dren-dk/HAL900/README

This project has been moved to gitlab: 
https://gitlab.com/dren.dk/HAL900
