dren-dk/HAL900/door-ctrl/firmware/em4100_protocol_files/psk_encoding.jpg

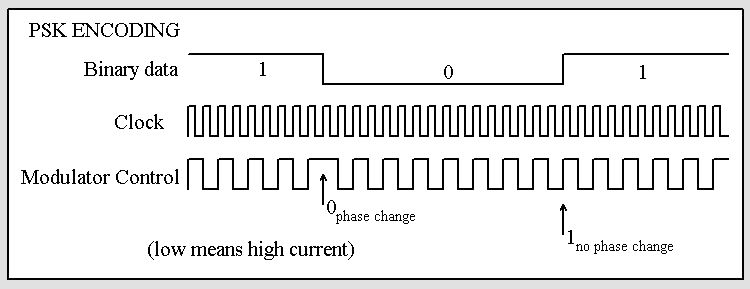
door-ctrl/firmware/em4100_protocol_files/psk_encoding.jpg
