dren-dk/HAL900/door-ctrl/historic/hardware-2.0/cerberus-h2.ods

Value | Component names | ELFA | Count | Price 1 | OSAA | URL | Normal total | OSAA total | ELFA | Count | Actual price
100nF 0805 | C1 C2 C6 C7 C8 C9 C10 C11 C12 C13 C14 C19 C23 C26 C28 C29 C31 | 65-724-19 | 17 | 0.37 | 0.08 | https://www.elfa.se/elfa3~dk_en/elfa/init.do?item=65-724-19 | 6.29 | 1.36 | 65-724-19 | 200 | 16
10uF 0805 | C15 C16 | 65-721-11 | 2 | 0.96 | 0.52 | https://www.elfa.se/elfa3~dk_en/elfa/init.do?item=65-721-11 | 1.92 | 1.04 | 65-721-11 | 20 | 10.4
2.2 uF C1206 | C20 | 65-834-54 | 1 | 1.09 | 0.258 | https://www.elfa.se/elfa3~dk_en/elfa/init.do?item=65-834-54 | 1.09 | 0.26 | 65-834-54 | 10 | 2.58
2.2 nF 0805 | C21 | 65-724-09 | 1 | 0.37 | 0.08 | https://www.elfa.se/elfa3~dk_en/elfa/init.do?item=65-724-09 | 0.37 | 0.08 | 65-724-09 | 10 | 0.8
33nF 0805 | C22 | 65-766-72 | 1 | 0.08 | 0.08 | https://www.elfa.se/elfa3~dk_en/elfa/init.do?item=65-766-72 | 0.08 | 0.08 | 65-766-72 | 10 | 0.8
3n3 0805 | C24 | 65-724-10 | 1 | 0.37 | 0.08 | https://www.elfa.se/elfa3~dk_en/elfa/init.do?item=65-724-10 | 0.37 | 0.08 | 65-724-10 | 10 | 0.8
1nF 0805 | C25 C27 C30 | 65-724-07 | 3 | 0.37 | 0.08 | https://www.elfa.se/elfa3~dk_en/elfa/init.do?item=65-724-07 | 1.11 | 0.24 | 65-724-07 | 30 | 2.4
10uF 1210 | C3 | 65-721-16 | 1 | 3.01 | 1.84 | https://www.elfa.se/elfa3~dk_en/elfa/init.do?item=65-721-16 | 3.01 | 1.84 | 65-721-16 | 5 | 9.2
16p 0805 | C4 C5 | 65-723-94 | 2 | 0.37 | 0.08 | https://www.elfa.se/elfa3~dk_en/elfa/init.do?item=65-723-94 | 0.74 | 0.16 | 65-723-94 | 20 | 1.6
 |  |  |  |  |  |  |  |  |  |  | 0
MINIMELF | D1 D2 D16 | 70-186-09 | 3 | 0.42 | 0.21 | https://www.elfa.se/elfa3~dk_en/elfa/init.do?item=70-186-09 | 1.26 | 0.63 | 70-186-09 | 30 | 6.3
3v6 SOD80C | D14 | 70-090-67 | 1 | 0.431 | 0.242 | https://www.elfa.se/elfa3~dk_en/elfa/init.do?item=70-090-67 | 0.43 | 0.24 | 70-090-67 | 10 | 2.42
TO220ACS | D15 | 70-140-30 | 1 | 4.33 | 2.57 | https://www.elfa.se/elfa3~dk_en/elfa/init.do?item=70-140-30 | 4.33 | 2.57 | 70-140-30 | 6 | 15.42
BAV70 SOT23 | D3 D4 D5 D6 D7 D8 D9 D10 D11 D12 D13 | 70-306-87 | 11 | 1.07 | 0.321 | https://www.elfa.se/elfa3~dk_en/elfa/init.do?item=70-306-87 | 11.77 | 3.53 | 70-306-87 | 50 | 16.05
 |  |  |  |  |  |  |  |  | 0 |  | 0
ENC28J60SS SSOP28 | IC1 | 73-867-45 | 1 | 19.8 | 15.3 | https://www.elfa.se/elfa3~dk_en/elfa/init.do?item=73-867-45 | 19.80 | 15.30 | 73-867-45 | 5 | 76.5
ATmega168 TQFP32-08 | IC2 | 73-647-08 | 1 | 39.2 | 19 | https://www.elfa.se/elfa3~dk_en/elfa/init.do?item=73-647-08 | 39.20 | 19.00 | 73-647-08 | 5 | 95
24LC64SN SO-08 | IC3 | 73-786-19 | 1 | 6.67 | 3.16 | https://www.elfa.se/elfa3~dk_en/elfa/init.do?item=73-786-19 | 6.67 | 3.16 | 73-786-19 | 5 | 15.8
LD117AS33TR SOT223 | IC4 | 73-067-85 | 1 | 6.67 | 4.03 | https://www.elfa.se/elfa3~dk_en/elfa/init.do?item=73-067-85 | 6.67 | 4.03 | 73-067-85 | 5 | 20.15
LM358 SO08 | IC6 | 73-301-29 | 1 | 3.59 | 1.76 | https://www.elfa.se/elfa3~dk_en/elfa/init.do?item=73-301-29 | 3.59 | 1.76 | 73-301-29 | 5 | 8.8
MC78M05CDTG DPACK | IC7 | 73-286-76 | 1 | 2.64 | 1.84 | https://www.elfa.se/elfa3~dk_en/elfa/init.do?item=73-286-76 | 2.64 | 1.84 | 73-286-76 | 5 | 9.2
 |  |  |  |  |  |  |  |  | 0 |  | 0
HF33F/012-ZS3 047 G5SB | K1 K2 | 37-157-45 | 2 | 15 | 10.7 | https://www.elfa.se/elfa3~dk_en/elfa/init.do?item=37-157-45 | 30.00 | 21.40 | 37-157-45 | 4 | 42.8
 |  |  |  |  |  |  |  |  | 0 |  | 0
ferrite bead 0204V@1 | L1, L4 | 58-727-00 | 2 | 1.25 | 0.81 | https://www.elfa.se/elfa3~dk_en/elfa/init.do?item=58-727-00 | 2.50 | 1.62 | 58-727-00 | 10 | 8.1
220uH A26GFC | L3 | 58-113-71 | 1 | 14.6 | 9.09 | https://www.elfa.se/elfa3~dk_en/elfa/init.do?item=58-113-71 | 14.60 | 9.09 | 58-113-71 | 5 | 45.45
 |  |  |  |  |  |  |  |  | 0 |  | 0
CHIP-LED0805 | LED1 LED2 | 75-102-55 | 2 | 0.88 | 0.52 | https://www.elfa.se/elfa3~dk_en/elfa/init.do?item=75-102-55 | 1.76 | 1.04 | 75-102-55 | 20 | 10.4
25MHz HC49UP | Q1 | 74-521-96 | 1 | 4.77 | 2.79 | https://www.elfa.se/elfa3~dk_en/elfa/init.do?item=74-521-96 | 4.77 | 2.79 | 74-521-96 | 5 | 13.95
 |  |  |  |  |  |  |  |  | 0 |  | 0
470 0805 | R1 R2 R13 R15 | 60-174-12 | 4 | 0.712 | 0.228 | https://www.elfa.se/elfa3~dk_en/elfa/init.do?item=60-174-12 | 2.85 | 0.91 | 60-174-12 | 40 | 9.12
2k7 0805 | R10 | 60-175-94 | 1 | 0.712 | 0.228 | https://www.elfa.se/elfa3~dk_en/elfa/init.do?item=60-175-94 | 0.71 | 0.23 | 60-175-94 | 10 | 2.28
18k 0805 | R11 | 60-177-92 | 1 | 0.712 | 0.228 | https://www.elfa.se/elfa3~dk_en/elfa/init.do?item=60-177-92 | 0.71 | 0.23 | 60-177-92 | 10 | 2.28
4k7 0805 | R12 R14 R33 R35 R37 R51 R52 | 60-176-51 | 7 | 0.712 | 0.228 | https://www.elfa.se/elfa3~dk_en/elfa/init.do?item=60-176-51 | 4.98 | 1.60 | 60-176-51 | 50 | 11.4
1k 0805 | R16 R17 R18 R19 R20 R21 R22 R23 R24 R25 R26 R27 R28 R29 R30 R31 R32 R38 R39 R40 R48 | 60-174-95 | 21 | 0.712 | 0.228 | https://www.elfa.se/elfa3~dk_en/elfa/init.do?item=60-174-95 | 14.95 | 4.79 | 60-174-95 | 100 | 22.8
50 0805 | R3 R4 R5 R6 | 60-171-80 | 4 | 0.712 | 0.228 | https://www.elfa.se/elfa3~dk_en/elfa/init.do?item=60-171-80 | 2.85 | 0.91 | 60-171-80 | 40 | 9.12
6k2 0805 | R34 | 60-176-85 | 1 | 0.712 | 0.228 | https://www.elfa.se/elfa3~dk_en/elfa/init.do?item=60-176-85 | 0.71 | 0.23 | 60-176-85 | 10 | 2.28
15k 0805 | R36 | 60-177-76 | 1 | 0.712 | 0.228 | https://www.elfa.se/elfa3~dk_en/elfa/init.do?item=60-177-76 | 0.71 | 0.23 | 60-177-76 | 10 | 2.28
10R 0805 | R41 | 60-170-16 | 1 | 0.712 | 0.228 | https://www.elfa.se/elfa3~dk_en/elfa/init.do?item=60-170-16 | 0.71 | 0.23 | 60-170-16 | 10 | 2.28
100k 0805 | R43 R46 R50 | 60-179-74 | 3 | 0.712 | 0.228 | https://www.elfa.se/elfa3~dk_en/elfa/init.do?item=60-179-74 | 2.14 | 0.68 | 60-179-74 | 30 | 6.84
22k 0805 | R45 | 60-178-18 | 1 | 0.712 | 0.228 | https://www.elfa.se/elfa3~dk_en/elfa/init.do?item=60-178-18 | 0.71 | 0.23 | 60-178-18 | 10 | 2.28
330R 0805 | R7 R44 | 60-173-70 | 2 | 0.712 | 0.228 | https://www.elfa.se/elfa3~dk_en/elfa/init.do?item=60-173-70 | 1.42 | 0.46 | 60-173-70 | 20 | 4.56
10k 0805 | R8 R9 R42 R49 R53 | 60-177-35 | 5 | 0.712 | 0.228 | https://www.elfa.se/elfa3~dk_en/elfa/init.do?item=60-177-35 | 3.56 | 1.14 | 60-177-35 | 50 | 11.4
 |  |  |  |  |  |  |  |  | 0 |  | 0
ICSP MA03-2 | SV1 | 43-839-24 | 0.166666666666667 | 20.7 | 17 | https://www.elfa.se/elfa3~dk_en/elfa/init.do?item=43-839-24 | 3.45 | 2.83 | 43-839-24 | 1 | 17
serial MA06-2 | SV2 | 43-839-24 | 0.166666666666667 | 20.7 | 17 | https://www.elfa.se/elfa3~dk_en/elfa/init.do?item=43-839-24 | 3.45 | 2.83 | 43-839-24 | 1 | 17
GPIO MA06-2 | SV3 | 43-839-24 | 0.0833333333333333 | 20.7 | 17 | https://www.elfa.se/elfa3~dk_en/elfa/init.do?item=43-839-24 | 1.73 | 1.42 | 43-839-24 | 1 | 17
 |  |  |  |  |  |  |  |  | 0 |  | 0
BC817 SOT-23 | T1 T2 T4 T5 | 71-311-95 | 4 | 0.338 | 0.233 | https://www.elfa.se/elfa3~dk_en/elfa/init.do?item=71-311-95 | 1.35 | 0.93 | 71-311-95 | 40 | 9.32
BC807 SOT-23 | T3 | 71-311-98 | 1 | 0.409 | 0.281 | https://www.elfa.se/elfa3~dk_en/elfa/init.do?item=71-311-98 | 0.41 | 0.28 | 71-311-98 | 10 | 2.81
 |  |  |  |  |  |  |  |  | 0 |  | 0
W237-103 | X1 X2 | 48-375-14 | 2 | 3.67 | 1.62 | https://www.elfa.se/elfa3~dk_en/elfa/init.do?item=48-375-14 | 7.34 | 3.24 | 48-375-14 | 20 | 32.4
W237-102 | X3 | 48-375-06 | 1 | 2.5 | 1.1 | https://www.elfa.se/elfa3~dk_en/elfa/init.do?item=48-375-06 | 2.50 | 1.10 | 48-375-06 | 10 | 11
 |  |  |  |  |  | total pris for komponenter, normal og OSAA | 222.22 | 117.63 |  |  | 626.37
 |  |  |  |  |  | Incl. Moms | 277.78 | 147.04 |  |  | 782.9625
