dren-dk/HAL900/door-ctrl/historic/hardware-2.0/cerberus-h2-rfid.pdf

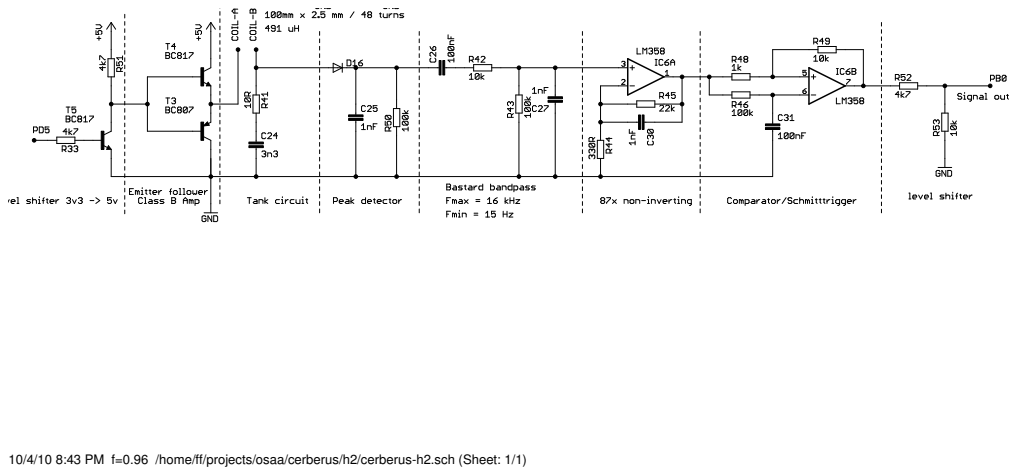
[picture p10: page 1]

10/4/10 8:43 PM f=0.96 /home/ff/projects/osaa/cerberus/h2/cerberus-h2.sch (Sheet: 1/1)
