dren-dk/HAL900/door-ctrl/historic/hardware-2.0/cerberus-h2.pdf

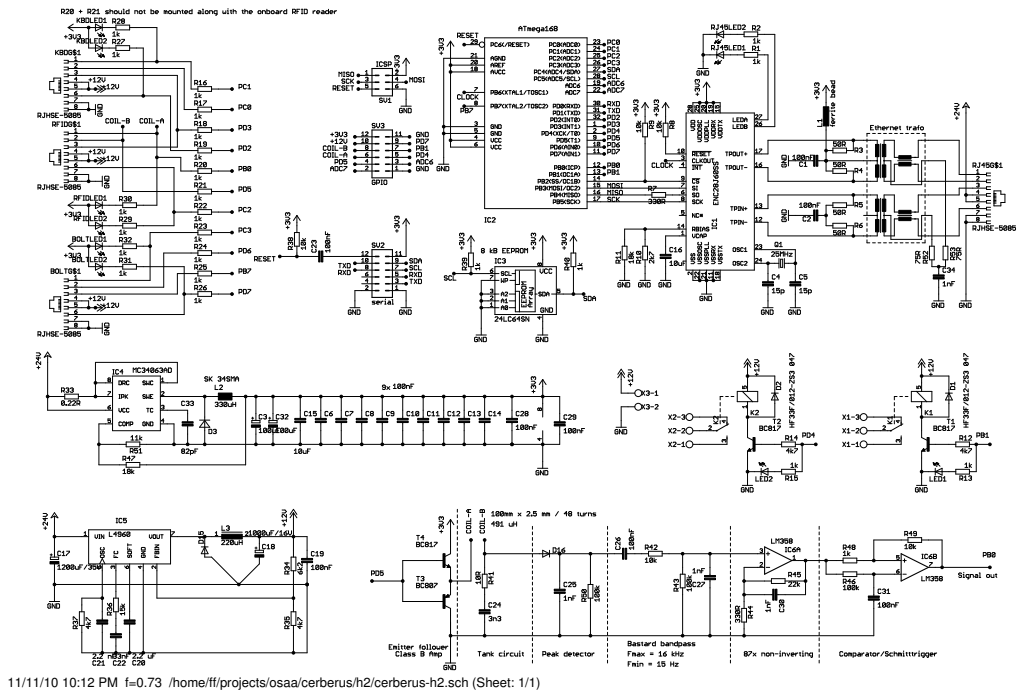
[picture p11: page 1]

11/11/10 10:12 PM f=0.73 /home/ff/projects/osaa/cerberus/h2/cerberus-h2.sch (Sheet: 1/1)
