dren-dk/HAL900/door-ctrl/historic/hardware-2.0/sn/sniffer-nano-v2.pdf

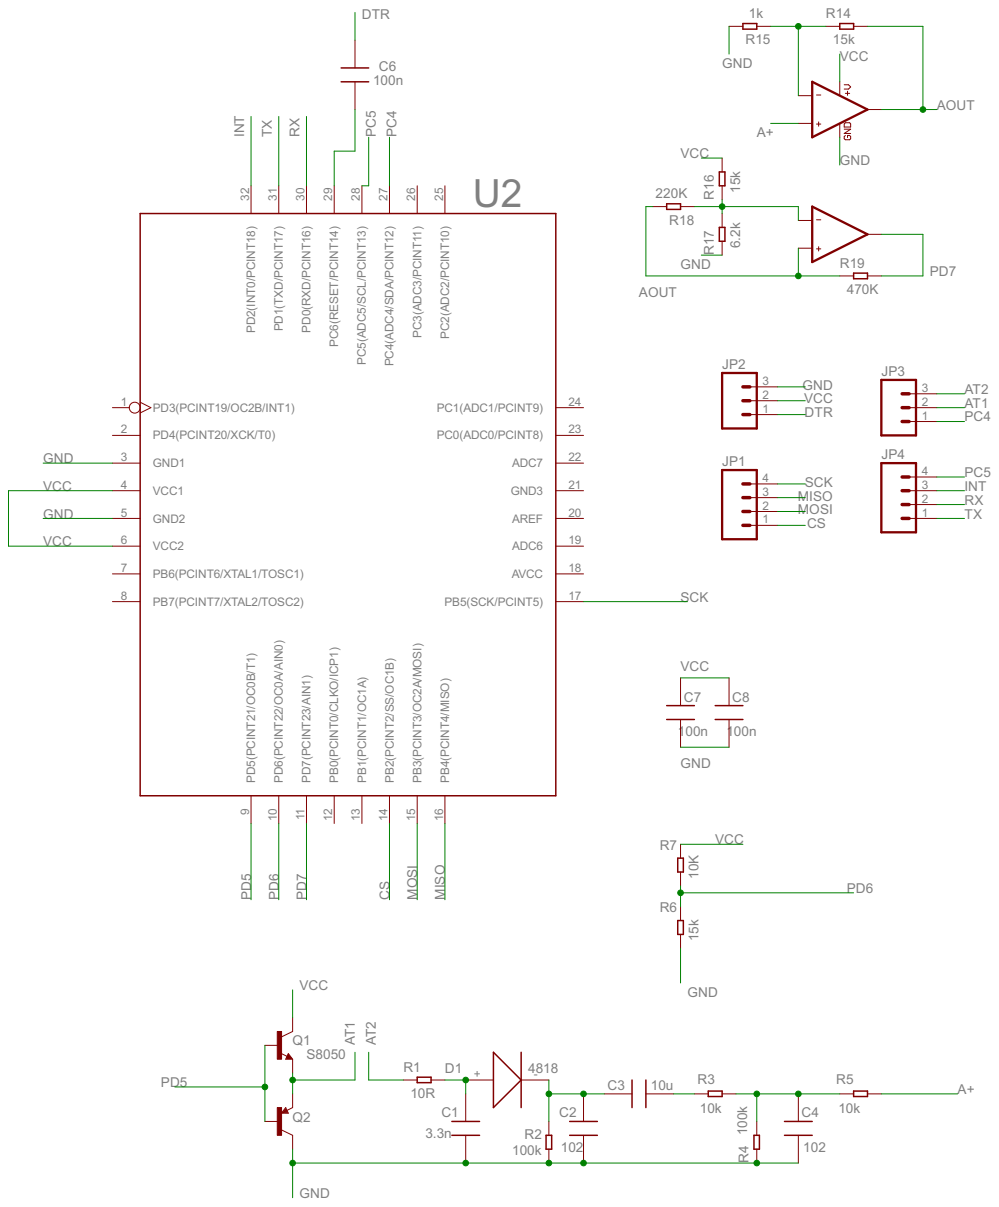
[picture p12: page 1]

PC2(ADC2/PCINT10) 25 PC3(ADC3/PCINT11) 26 PC4(ADC4/SDA/PCINT12) 27 PC5(ADC5/SCL/PCINT13) 28 PC6(RESET/PCINT14) 29 PD0(RXD/PCINT16) 30 PD1(TXD/PCINT17) 31 PD2(INT0/PCINT18) 32U2

PD5(PCINT21/OC0B/T1) 9 PD6(PCINT22/OC0A/AIN0) 10 PD7(PCINT23/AIN1) 11 PB0(PCINT0/CLKO/ICP1) 12 PB1(PCINT1/OC1A) 13 PB2(PCINT2/SS/OC1B) 14 PB3(PCINT3/OC2A/MOSI) 15 PB4(PCINT4/MISO) 16 PB5(SCK/PCINT5) 17 AVCC
