dren-dk/HAL900/door-ctrl/hardware-4/doorctrl-rs485.sch

## KiCad design door-ctrl/hardware-4/doorctrl-rs485.sch (2011-05-03)

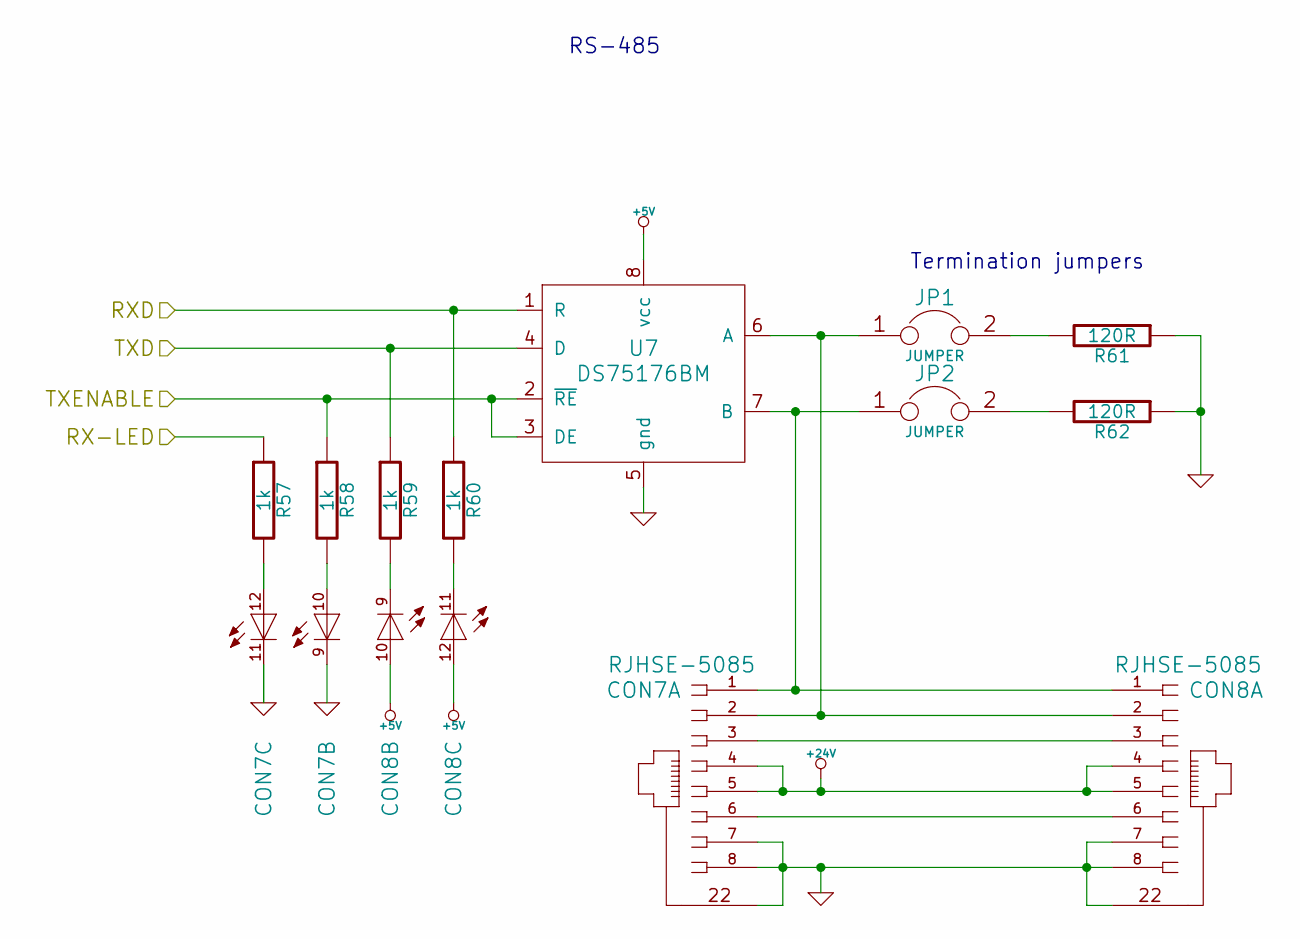
[picture p13: schematic doorctrl-rs485.sch]

Parts:
CON7, CON8: RJHSE-5085
JP1, JP2: JUMPER
R57, R58, R59, R60: 1k
R61, R62: 120R
U7: DS75176BM; so8

Connections:
+5V: CON8.10 (A), CON8.12 (A), U7.8 (vcc)
+24V: CON7.4, CON7.5, CON8.4, CON8.5
GND: CON7.7, CON7.8, CON7.9 (C), CON7.11 (C), CON7.22 (shield), CON8.7, CON8.8, CON8.22 (shield), R61.1, R62.1, U7.5 (gnd)
unnamed: CON7.1, CON8.1, JP2.1, U7.7 (B)
unnamed: CON7.2, CON8.2, JP1.1, U7.6 (A)
unnamed: CON7.3, CON8.3
unnamed: CON7.6, CON8.6
unnamed: CON7.10 (A), R58.2
unnamed: CON7.12 (A), R57.2
unnamed: CON8.9 (C), R59.2
unnamed: CON8.11 (C), R60.2
unnamed: JP1.2, R61.2
unnamed: JP2.2, R62.2
RX-LED: R57.1
RXD: R60.1, U7.1 (R)
TXD: R59.1, U7.4 (D)
TXENABLE: R58.1, U7.2 (~RE), U7.3 (DE)

Notes on the sheet:
Termination jumpers
RS-485
