dren-dk/HAL900/door-ctrl/hardware-4/doorctrl-v4-gpio.sch

## KiCad design door-ctrl/hardware-4/doorctrl-v4-gpio.sch (2011-05-03)

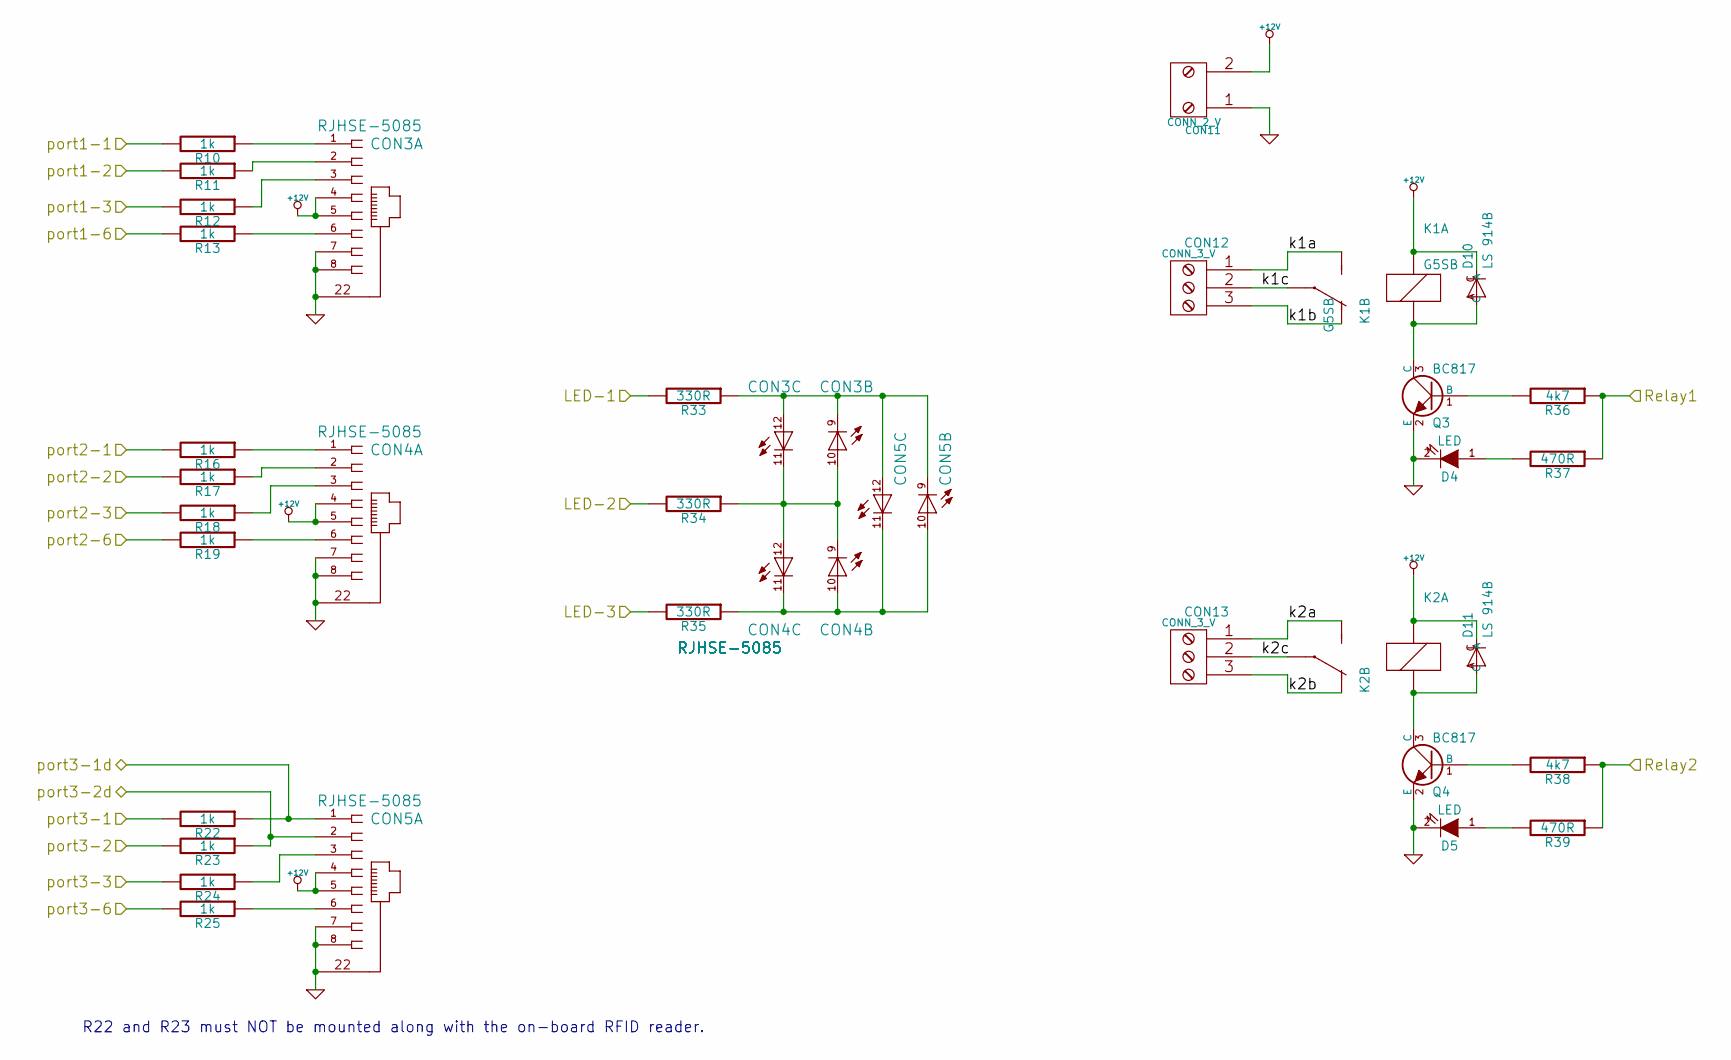
[picture p14: schematic doorctrl-v4-gpio.sch]

Parts:
CON3, CON4, CON5: RJHSE-5085
CON11: CONN_2_V
CON12, CON13: CONN_3_V
D4, D5: LED
D10, D11: LS 914B; diode-MINIMELF
K1: G5SB
K2: G5SB; g5sb
Q3, Q4: BC817
R10, R11, R12, R13, R16, R17, R18, R19, R22, R23, R24, R25: 1k
R33, R34, R35: 330R
R36, R38: 4k7
R37, R39: 470R

Connections:
+12V: CON3.4, CON3.5, CON4.4, CON4.5, CON5.4, CON5.5, CON11.2, D10.C, D11.C, K1.1, K2.1
GND: CON3.7, CON3.8, CON3.22 (shield), CON4.7, CON4.8, CON4.22 (shield), CON5.7, CON5.8, CON5.22 (shield), CON11.1, D4.2 (K), D5.2 (K), Q3.2 (E), Q4.2 (E)
LED-1: R33.2
LED-2: R34.2
LED-3: R35.2
unnamed: CON3.1, R10.1
unnamed: CON3.2, R11.1
unnamed: CON3.3, R12.1
unnamed: CON3.6, R13.1
unnamed: CON3.10 (A), CON3.11 (C), CON4.9 (C), CON4.12 (A), R34.1
unnamed: CON3.9 (C), CON3.12 (A), CON5.9 (C), CON5.12 (A), R33.1
unnamed: CON4.1, R16.1
unnamed: CON4.2, R17.1
unnamed: CON4.3, R18.1
unnamed: CON4.6, R19.1
unnamed: CON4.10 (A), CON4.11 (C), CON5.10 (A), CON5.11 (C), R35.1
unnamed: CON5.3, R24.1
unnamed: CON5.6, R25.1
unnamed: D4.1 (A), R37.2
unnamed: D5.1 (A), R39.2
unnamed: D10.A, K1.5 (2), Q3.3 (C)
unnamed: D11.A, K2.5 (2), Q4.3 (C)
unnamed: Q3.1 (B), R36.2
unnamed: Q4.1 (B), R38.2
Relay1: R36.1, R37.1
Relay2: R38.1, R39.1
k1a: CON12.1, K1.3 (S)
k1b: CON12.3, K1.4 (O)
k1c: CON12.2, K1.2
k2a: CON13.1, K2.3 (S)
k2b: CON13.3, K2.4 (O)
k2c: CON13.2, K2.2
port1-1: R10.2
port1-2: R11.2
port1-3: R12.2
port1-6: R13.2
port2-1: R16.2
port2-2: R17.2
port2-3: R18.2
port2-6: R19.2
port3-1: R22.2
port3-1d: CON5.1, R22.1
port3-2: R23.2
port3-2d: CON5.2, R23.1
port3-3: R24.2
port3-6: R25.2

Notes on the sheet:
R22 and R23 must NOT be mounted along with the on-board RFID reader.
