dren-dk/HAL900/door-ctrl/hardware-4/doorctrl-v4-net.sch

## KiCad design door-ctrl/hardware-4/doorctrl-v4-net.sch (2011-05-03)

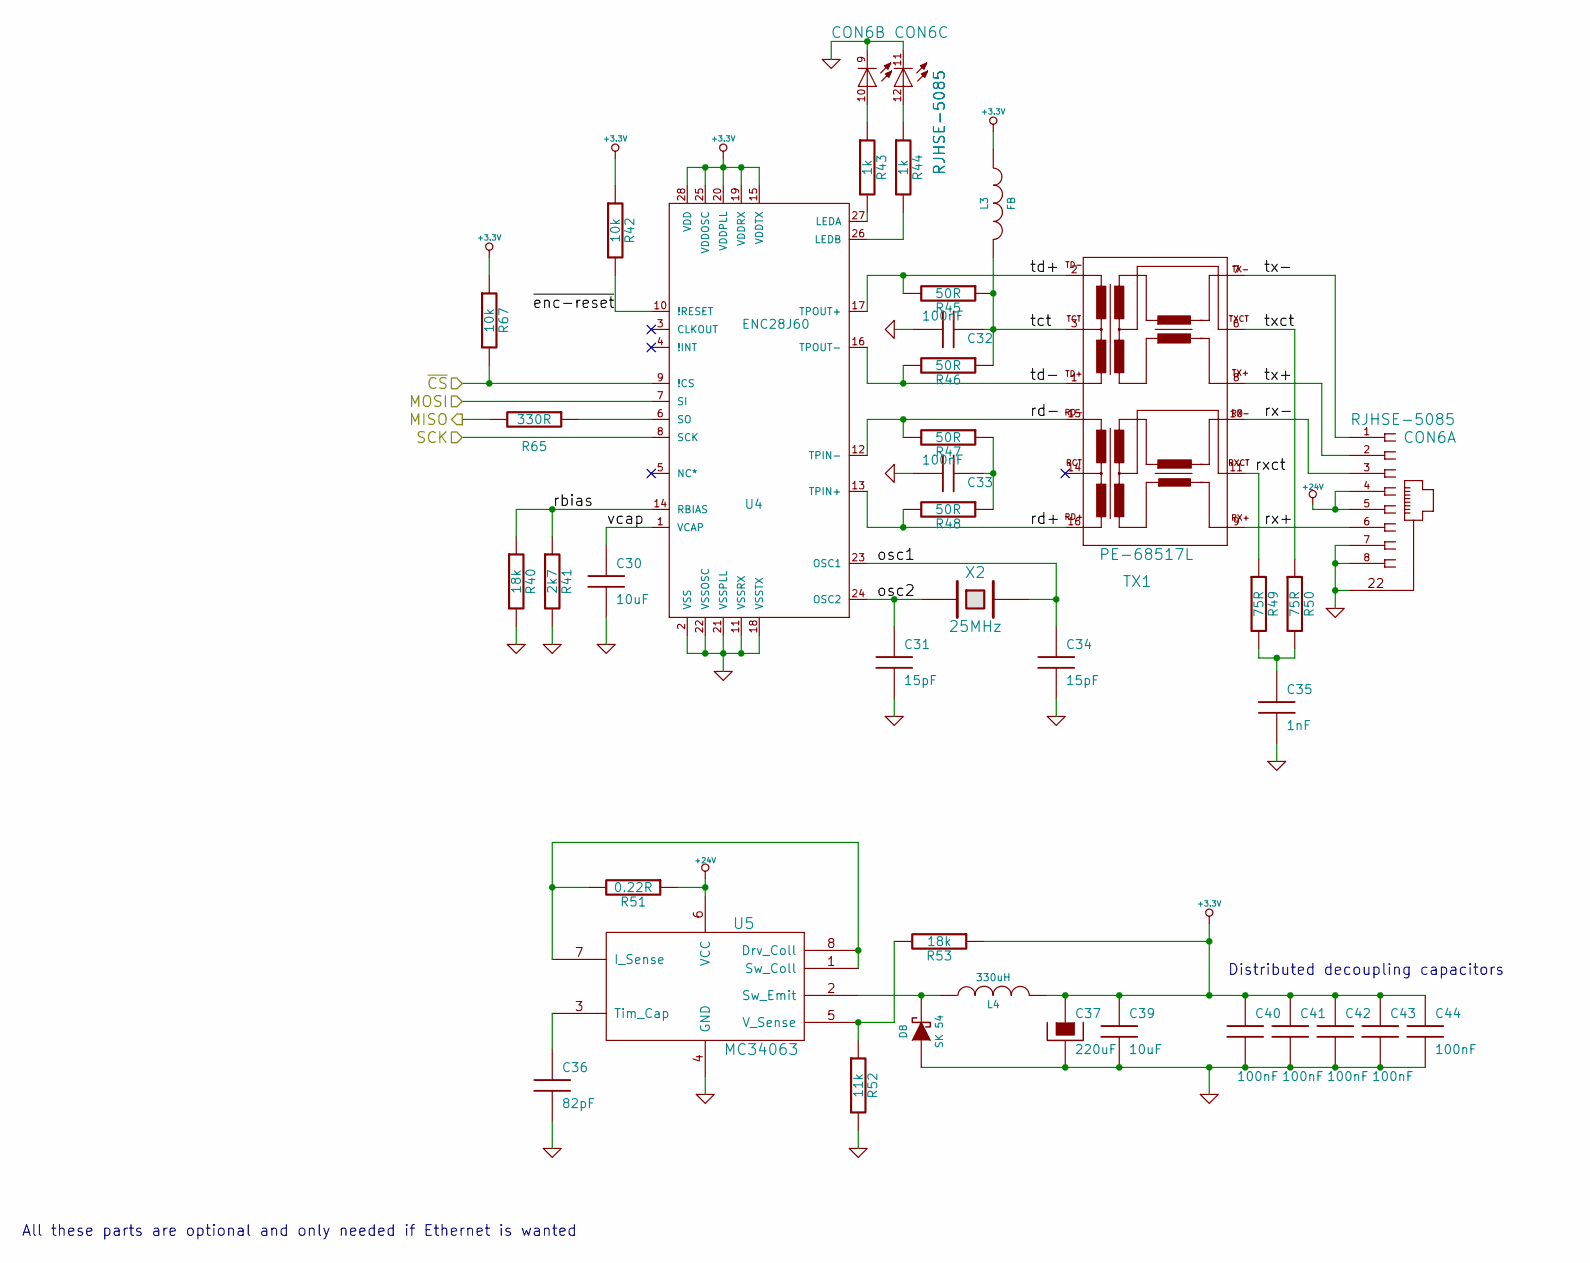
[picture p15: schematic doorctrl-v4-net.sch]

Parts:
C30, C39: 10uF
C31, C34: 15pF
C32, C33, C40, C41, C42, C43, C44: 100nF
C35: 1nF
C36: 82pF
C37: 220uF
CON6: RJHSE-5085
D8: SK 54
L3: FB
L4: 330uH
R40, R53: 18k
R41: 2k7
R42, R67: 10k
R43, R44: 1k
R45, R46, R47, R48: 50R
R49, R50: 75R
R51: 0.22R
R52: 11k
R65: 330R
TX1: PE-68517L
U4: ENC28J60
U5: MC34063
X2: 25MHz

Connections:
+3.3V: C37.1, C39.1, C40.1, C41.1, C42.1, C43.1, C44.1, L3.1, L4.2, R42.1, R53.1, R67.1, U4.15 (VDDTX), U4.19 (VDDRX), U4.20 (VDDPLL), U4.25 (VDDOSC), U4.28 (VDD)
+24V: CON6.4, CON6.5, R51.1, U5.6 (VCC)
GND: C30.2, C31.2, C32.2, C33.2, C34.2, C35.2, C36.2, C37.2, C39.2, C40.2, C41.2, C42.2, C43.2, C44.2, CON6.7, CON6.8, CON6.9 (C), CON6.11 (C), CON6.22 (shield), D8.1 (A), R40.2, R41.2, R52.2, U4.2 (VSS), U4.11 (VSSRX), U4.18 (VSSTX), U4.21 (VSSPLL), U4.22 (VSSOSC), U5.4 (GND)
MISO: R65.2
MOSI: U4.7 (SI)
unnamed: C33.1, R47.1, R48.1
unnamed: C35.1, R49.2, R50.2
unnamed: C36.1, U5.3 (Tim_Cap)
unnamed: CON6.10 (A), R43.1
unnamed: CON6.12 (A), R44.1
unnamed: D8.2 (K), L4.1, U5.2 (Sw_Emit)
unnamed: R43.2, U4.27 (LEDA)
unnamed: R44.2, U4.26 (LEDB)
unnamed: R51.2, U5.1 (Sw_Coll), U5.7 (I_Sense), U5.8 (Drv_Coll)
unnamed: R52.1, R53.2, U5.5 (V_Sense)
unnamed: R65.1, U4.6 (SO)
SCK: U4.8 (SCK)
osc1: C34.1, U4.23 (OSC1), X2.2
osc2: C31.1, U4.24 (OSC2), X2.1
rbias: R40.1, R41.1, U4.14 (RBIAS)
rd+: R48.2, TX1.16 (RD+), U4.13 (TPIN+)
rd-: R47.2, TX1.15 (RD-), U4.12 (TPIN-)
rx+: CON6.6, TX1.9 (RX+)
rx-: CON6.3, TX1.10 (RX-)
rxct: R49.1, TX1.11 (RXCT)
tct: C32.1, L3.2, R45.1, R46.1, TX1.3 (TCT)
td+: R45.2, TX1.2 (TD-), U4.17 (TPOUT+)
td-: R46.2, TX1.1 (TD+), U4.16 (TPOUT-)
tx+: CON6.2, TX1.8 (TX+)
tx-: CON6.1, TX1.7 (TX-)
txct: R50.1, TX1.6 (TXCT)
vcap: C30.1, U4.1 (VCAP)
~CS: R67.2, U4.9 (!CS)
~enc-reset: R42.2, U4.10 (!RESET)

Notes on the sheet:
All these parts are optional and only needed if Ethernet is wanted
Distributed decoupling capacitors
