dren-dk/HAL900/door-ctrl/tapeout/hardware-4.0.20110101/doorctrl-v4-psu.sch

## KiCad design door-ctrl/tapeout/hardware-4.0.20110101/doorctrl-v4-psu.sch (2011-02-06)

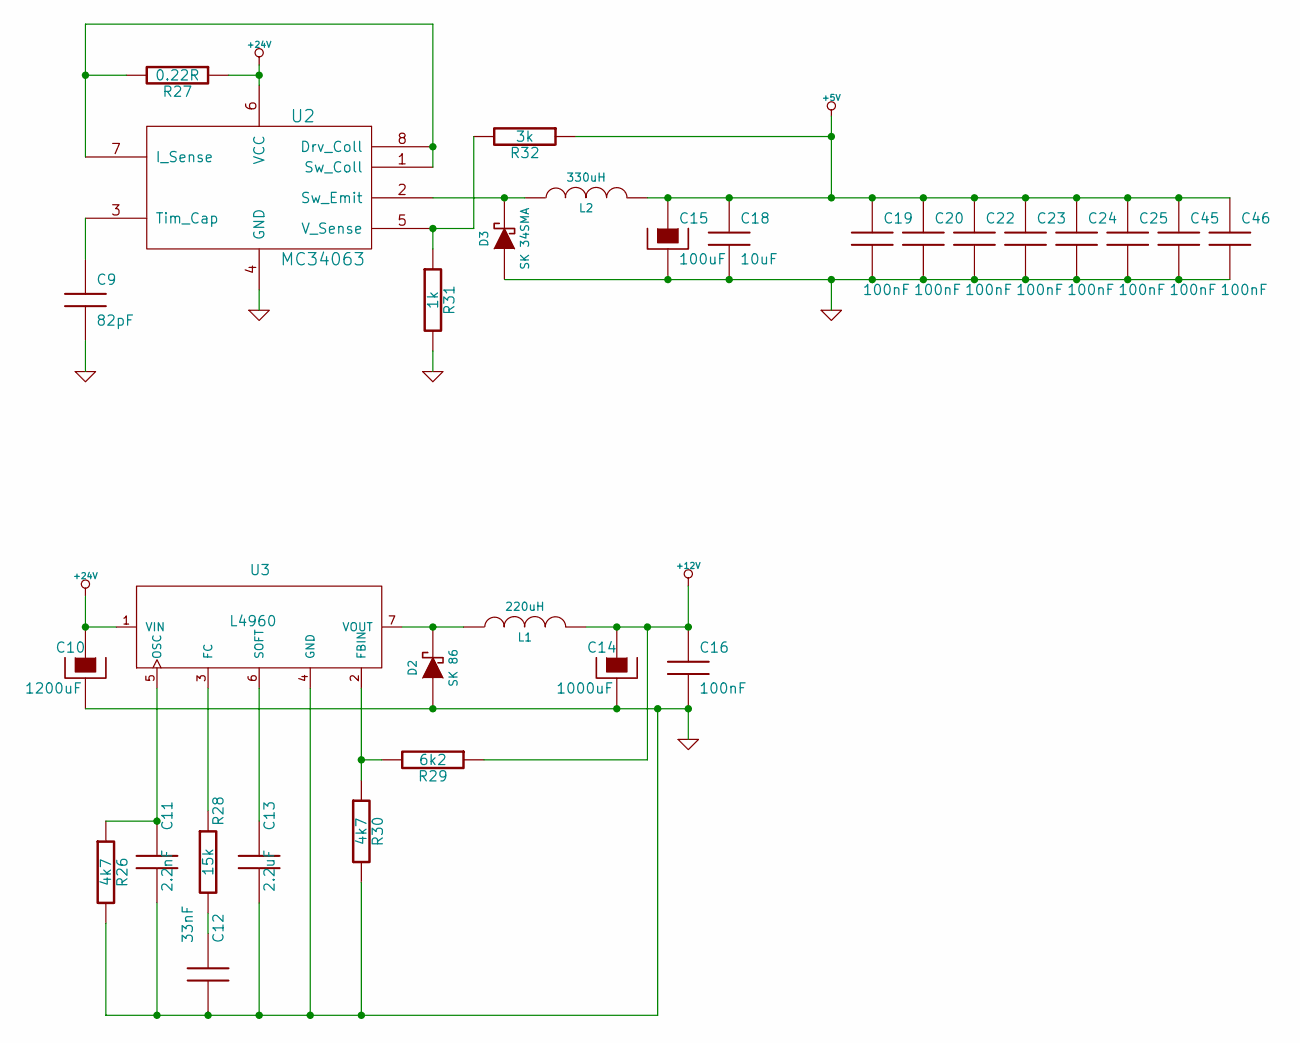
[picture p19: schematic doorctrl-v4-psu.sch]

Parts:
C9: 82pF
C10: 1200uF
C11: 2.2nF
C12: 33nF
C13: 2.2uF
C14: 1000uF
C15: 100uF
C16, C19, C20, C22, C23, C24, C25, C45, C46: 100nF
C18: 10uF
D2: SK 86
D3: SK 34SMA
L1: 220uH
L2: 330uH
R26, R30: 4k7
R27: 0.22R
R28: 15k
R29: 6k2
R31: 1k
R32: 3k
U2: MC34063
U3: L4960; l4960-HEPTAWATT

Connections:
+5V: C15.1, C18.1, C19.1, C20.1, C22.1, C23.1, C24.1, C25.1, C45.1, C46.1, L2.2, R32.1
+12V: C14.1, C16.1, L1.2, R29.1
+24V: C10.1, R27.1, U2.6 (VCC), U3.1 (VIN)
GND: C9.2, C10.2, C11.2, C12.2, C13.2, C14.2, C15.2, C16.2, C18.2, C19.2, C20.2, C22.2, C23.2, C24.2, C25.2, C45.2, C46.2, D2.1 (A), D3.1 (A), R26.2, R30.2, R31.2, U2.4 (GND), U3.4 (GND)
unnamed: C9.1, U2.3 (Tim_Cap)
unnamed: C11.1, R26.1, U3.5 (OSC)
unnamed: C12.1, R28.2
unnamed: C13.1, U3.6 (SOFT)
unnamed: D2.2 (K), L1.1, U3.7 (VOUT)
unnamed: D3.2 (K), L2.1, U2.2 (Sw_Emit)
unnamed: R27.2, U2.1 (Sw_Coll), U2.7 (I_Sense), U2.8 (Drv_Coll)
unnamed: R28.1, U3.3 (FC)
unnamed: R29.2, R30.1, U3.2 (FBIN)
unnamed: R31.1, R32.2, U2.5 (V_Sense)
