dren-dk/HAL900/door-ctrl/tapeout/hardware-4.0.20110101/doorctrl-v4.sch

## KiCad design door-ctrl/tapeout/hardware-4.0.20110101/doorctrl-v4.sch (2011-02-06)

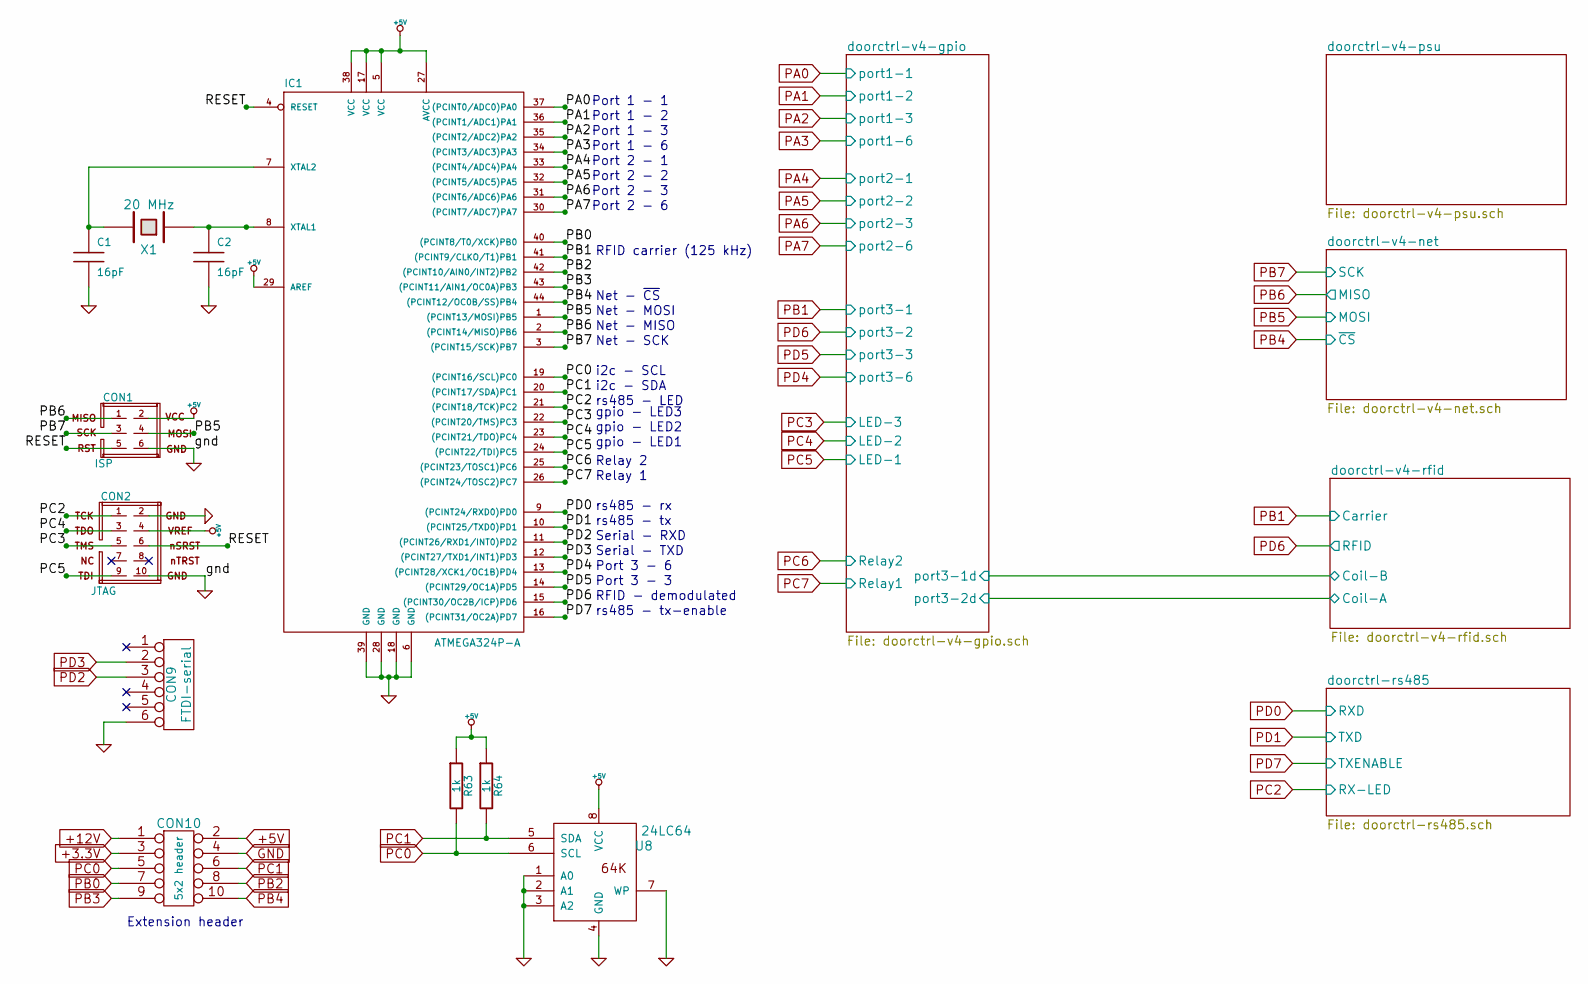
[picture p20: schematic doorctrl-v4.sch]

Parts:
C1, C2: 16pF
CON1: ISP; AVR-ISP-6
CON2: JTAG; AVR-JTAG-10
CON9: FTDI-serial
CON10: 5x2 header
IC1: ATMEGA324P-A; TQFP44
R63, R64: 1k
U8: 24LC64
X1: 20 MHz

Connections:
+3.3V: CON10.3
+5V: CON1.2, CON2.4, CON10.2, IC1.5 (VCC), IC1.17 (VCC), IC1.27 (AVCC), IC1.29 (AREF), IC1.38 (VCC), R63.1, R64.1, U8.8 (VCC)
+12V: CON10.1
unnamed: C1.1, IC1.7 (XTAL2), X1.2
unnamed: C2.1, IC1.8 (XTAL1), X1.1
PA0: IC1.37 ((PCINT0/ADC0)PA0)
PA1: IC1.36 ((PCINT1/ADC1)PA1)
PA2: IC1.35 ((PCINT2/ADC2)PA2)
PA3: IC1.34 ((PCINT3/ADC3)PA3)
PA4: IC1.33 ((PCINT4/ADC4)PA4)
PA5: IC1.32 ((PCINT5/ADC5)PA5)
PA6: IC1.31 ((PCINT6/ADC6)PA6)
PA7: IC1.30 ((PCINT7/ADC7)PA7)
PB0: CON10.7, IC1.40 ((PCINT8/T0/XCK)PB0)
PB1: IC1.41 ((PCINT9/CLKO/T1)PB1)
PB2: CON10.8, IC1.42 ((PCINT10/AIN0/INT2)PB2)
PB3: CON10.9, IC1.43 ((PCINT11/AIN1/OC0A)PB3)
PB4: CON10.10, IC1.44 ((PCINT12/OC0B/SS)PB4)
PB5: CON1.4, IC1.1 ((PCINT13/MOSI)PB5)
PB6: CON1.1, IC1.2 ((PCINT14/MISO)PB6)
PB7: CON1.3, IC1.3 ((PCINT15/SCK)PB7)
PC0: CON10.5, IC1.19 ((PCINT16/SCL)PC0), R63.2, U8.6 (SCL)
PC1: CON10.6, IC1.20 ((PCINT17/SDA)PC1), R64.2, U8.5 (SDA)
PC2: CON2.1, IC1.21 ((PCINT18/TCK)PC2)
PC3: CON2.5, IC1.22 ((PCINT20/TMS)PC3)
PC4: CON2.3, IC1.23 ((PCINT21/TDO)PC4)
PC5: CON2.9, IC1.24 ((PCINT22/TDI)PC5)
PC6: IC1.25 ((PCINT23/TOSC1)PC6)
PC7: IC1.26 ((PCINT24/TOSC2)PC7)
PD0: IC1.9 ((PCINT24/RXD0)PD0)
PD1: IC1.10 ((PCINT25/TXD0)PD1)
PD2: CON9.3, IC1.11 ((PCINT26/RXD1/INT0)PD2)
PD3: CON9.2, IC1.12 ((PCINT27/TXD1/INT1)PD3)
PD4: IC1.13 ((PCINT28/XCK1/OC1B)PD4)
PD5: IC1.14 ((PCINT29/OC1A)PD5)
PD6: IC1.15 ((PCINT30/OC2B/ICP)PD6)
PD7: IC1.16 ((PCINT31/OC2A)PD7)
RESET: CON1.5, CON2.6, IC1.4 (RESET)
gnd: C1.2, C2.2, CON1.6, CON2.2, CON2.10, CON9.6, CON10.4, IC1.6 (GND), IC1.18 (GND), IC1.28 (GND), IC1.39 (GND), U8.1 (A0), U8.2 (A1), U8.3 (A2), U8.4 (GND), U8.7 (WP)

Notes on the sheet:
Extension header
Port 2 - 6
Port 2 - 3
Port 2 - 2
Port 2 - 1
Port 1 - 6
Port 1 - 3
Port 1 - 2
Port 1 - 1
Relay 2
Relay 1
Port 3 - 6
Port 3 - 3
Serial - TXD
Serial - RXD
i2c - SDA
i2c - SCL
Net - SCK
Net - MISO
Net - MOSI
Net - ~CS
RFID - demodulated
RFID carrier (125 kHz)
gpio - LED1
gpio - LED2
gpio - LED3
rs485 - LED
rs485 - tx-enable
rs485 - tx
rs485 - rx
