dren-dk/HAL900/door-ctrl/firmware/comms.c

#include <stdio.h>
#include <avr/io.h>
#include <util/delay.h>
#include <avr/eeprom.h> 
#include <stdio.h>
#include <stdint.h>

#include "ip_arp_udp_tcp.h"
#include "enc28j60.h"
#include "net.h"
#include "aes256.h"
#include "crc32.h"

#include "defines.h"
#include "telegram.h"
#include "comms.h"

#define BUFFER_SIZE 550

#if (USE_ETHERNET)
const uint8_t MYMAC[6] = ETHERNET_MAC;
const uint8_t MYIP[4]  = ETHERNET_IP;
#endif

const unsigned char AES_KEY[32] = {NODE_AES_KEY};


int rs485putchar(char c, FILE *stream) {
  if (c == '\a') {
      fputs("*ring*\n", stderr);
      return 0;
    }

  if (c == '\n') {
   rs485putchar('\r', stream);
  }
  loop_until_bit_is_set(UCSR0A, UDRE0);
  UDR0 = c;

  return 0;
}

int rs485getchar(FILE *stream) {

  if (UCSR0A & 1<<RXC0) {
    if (UCSR0A & _BV(FE0)) {
      return _FDEV_EOF;
    }
    if (UCSR0A & _BV(DOR0)) {
      return _FDEV_ERR;
    }

    return UDR0;
  } else {
    return -1000;
  }
}

FILE rs485 = FDEV_SETUP_STREAM(rs485putchar, rs485getchar, _FDEV_SETUP_RW);

void rs485init() {
#if F_CPU < 2000000UL && defined(U2X)
  UCSR0A = _BV(U2X);             /* improve baud rate error by using 2x clk */
  UBRR0L = (F_CPU / (8UL * RS485_BAUD)) - 1;
#else
  UBRR0L = (F_CPU / (16UL * RS485_BAUD)) - 1;
#endif
  UCSR0B = _BV(TXEN0) | _BV(RXEN0); /* tx/rx enable */
}

void initComms() {
#if (USE_ETHERNET)
  enc28j60Init(MYMAC);
  //enc28j60clkout(2); // change clkout from 6.25MHz to 12.5MHz
  _delay_loop_1(0); // 60us

  // 0x476 is PHLCON LEDA=links status, LEDB=receive/transmit
  enc28j60PhyWrite(PHLCON,0x476);
  init_ip_arp_udp_tcp(MYMAC, MYIP, 0);
#endif

#ifdef RS485_ID
  DDRD |= _BV(PD1); // RS485 TXD
  DDRD |= _BV(PD7); // RS485 TX Enable.
  DDRC |= _BV(PC2); // RS485 RX LED
#endif
}


/**********************************************************************************************/
unsigned int logSeq=0;
void broadcastLog(struct LogTelegram *lt) {
  lt->type = 'L';
  lt->seq = logSeq++;

  lt->crc32 = crc32((unsigned char*)lt, 12);

  fprintf(stdout, "Log, seq:%d, crc: %lu, type:%c\n", lt->seq, lt->crc32, lt->logType);
  aes256_context ctx;
  aes256_init(&ctx, AES_KEY);
  aes256_encrypt_ecb(&ctx, (unsigned char *)lt);

#if (USE_ETHERNET)
  unsigned char transmitBuffer[UDP_DATA_P+32];
  spam_udp(transmitBuffer, (char *)lt, 16, UDP_PORT, 4747);
#endif
}

void logPowerUp() {
  struct LogTelegram lt;
  lt.logType = 'P';

  broadcastLog(&lt);
}

void logDeny() {
  struct LogTelegram lt;
  lt.logType = 'D';

  broadcastLog(&lt);
}

void logLocked() {
  struct LogTelegram lt;
  lt.logType = 'L';

  broadcastLog(&lt);
}

void logUnlock(unsigned long hash) {
  struct LogTelegram lt;
  lt.logType = 'U';
  lt.item.hash = hash;

  broadcastLog(&lt);
}

void logExit() {
  struct LogTelegram lt;
  lt.logType = 'E';

  broadcastLog(&lt);
}

void logKey(unsigned char key) {
  struct LogTelegram lt;
  lt.logType = 'K';
  lt.item.key = key;

  broadcastLog(&lt);
}

void logRfid(unsigned long rfid) {
  struct LogTelegram lt;
  lt.logType = 'R';
  lt.item.rfid = rfid;

  broadcastLog(&lt);
}

void logSensors(unsigned char sensors) {
  struct LogTelegram lt;
  lt.logType = 'S';
  lt.item.sensors = sensors;

  broadcastLog(&lt);
}


/**********************************************************************************************/

void sendAnswerTelegram(unsigned char *request, char *telegram) { // Stomps on telegram and request!

  // Affix crc in the right place.
  *((unsigned long *)(telegram+12)) = crc32((unsigned char*)telegram, 12);
  //fprintf(stdout, "Sending reply UDP package, crc is: %lu\n", *((unsigned long *)(telegram+12)));
  aes256_context ctx;
  aes256_init(&ctx, AES_KEY);
  aes256_encrypt_ecb(&ctx, (unsigned char *)telegram);

  //unsigned char transmitBuffer[UDP_DATA_P+32];
  //  send_udp(transmitBuffer, telegram, 16, UDP_PORT, dip, dport);
#if (USE_ETHERNET)
  make_udp_reply_from_request(request, telegram, 16, UDP_PORT);
#endif
}

void handlePing(unsigned char *request, struct PingPongTelegram *ping) {
  //  fprintf(stdout, "Got ping package, replying with pong\n");

  struct PingPongTelegram pong;

  pong.type = 'P';
  pong.seq = ping->seq;
  for (int i=0;i<9;i++) {
    pong.payload[i] = ping->payload[i] ^ ((i & 1) ? 0xaa : 0xbb);
  }

  sendAnswerTelegram(request, (char *)&pong);
}

void handleGetState(unsigned char *request) {

  struct StateTelegram reply;
  reply.type = 'G';
  reply.seq = eeprom_read_word((uint16_t *)EEPROM_SEQ);
  reply.version = 0;
  reply.sensorState = 0; // TODO: Figure out what to hook up where.

  sendAnswerTelegram(request, (char *)&reply);
}

void handleAddKey(unsigned char *request, struct AddDeleteKeyTelegram *payload) {

  struct AddDeleteKeyAnswerTelegram reply;
  reply.type='A';
  reply.seq=payload->seq;
  reply.result = 0;

  unsigned int currentSeq = eeprom_read_word((uint16_t *)EEPROM_SEQ);
  if (currentSeq != 0xffff && currentSeq > payload->seq) {
    reply.result = 2; // NACK
    //fprintf(stdout, "Ignoring write of key, because sequence number %u < %u\n", payload->seq, currentSeq);
  } else {

    // Find the first free slot in EEPROM
    int free = 0;
    while (free < 250) {
      unsigned long v = eeprom_read_dword((uint32_t *)(EEPROM_KEYS + (free << 2)));
      if (v == 0xffffffff) {
	break;
      }
      free++;
    }

    if (free >= 250) {
      //fprintf(stdout, "Failed to find free space for key\n");
      reply.result = 3; // NACK, no room

    } else {
      //fprintf(stdout, "Found free space for key at %u (seq: %u)\n", free, payload->seq);

      eeprom_write_dword((uint32_t *)(EEPROM_KEYS+ (free<<2)), payload->hash);
      eeprom_write_word((uint16_t *)EEPROM_SEQ, payload->seq);
      reply.result = 1; // ACK
    }
  }

  sendAnswerTelegram(request, (char *)&reply);
}

void handleDeleteKey(unsigned char *request, struct AddDeleteKeyTelegram *payload) {

  struct AddDeleteKeyAnswerTelegram reply;
  reply.type='D';
  reply.seq=payload->seq;
  reply.result = 0;

  unsigned int currentSeq = eeprom_read_word((uint16_t *)EEPROM_SEQ);
  if (currentSeq != 0xffff && currentSeq > payload->seq) {
    reply.result = 2; // NACK
    //fprintf(stdout, "Ignoring delete of key, because sequence number %u < %u\n", payload->seq, currentSeq);

  } else {
    // Find and nuke the key in EEPROM
    for (int i = 0; i < 250; i++) {
      unsigned long v = eeprom_read_dword((uint32_t *)(EEPROM_KEYS + (i << 2)));
      if (v == payload->hash) {
      	eeprom_write_dword((uint32_t *)(EEPROM_KEYS+ (i<<2)), 0xffffffff);
      	eeprom_write_word((uint16_t *)EEPROM_SEQ, payload->seq);
      	reply.result = 1; // ACK
      	break;
      }
    }

    if (reply.result != 1) {
      //fprintf(stdout, "Failed to find existing key to nuke.\n");
      reply.result = 3; // NACK, not found
    }
  }

  sendAnswerTelegram(request, (char *)&reply);
}

//#define LOG_PACKET

void handleTelegram(unsigned char *request, unsigned char *payload) {
  aes256_context ctx;
  aes256_init(&ctx, AES_KEY);
  aes256_decrypt_ecb(&ctx, payload);

  char *type = (char *)payload;
#ifdef LOG_PACKET
  unsigned int *seq = (unsigned int *)(payload+1);
#endif
  unsigned long *crc  = (unsigned long *)(payload+12);
  unsigned long realCRC = crc32((unsigned char *)payload, 12);

  if (*crc == realCRC) {
#ifdef LOG_PACKET
    fprintf(stdout, "Got package of type: '%c' seq: %d crc is ok: %lu\n", *type, *seq, realCRC);
#endif
    if (*type == 'p') {
      handlePing(request, (struct PingPongTelegram *)payload);

    } else if (*type == 'g') {
      handleGetState(request);

    } else if (*type == 'a') {
      handleAddKey(request, (struct AddDeleteKeyTelegram *)payload);

    } else if (*type == 'd') {
      handleDeleteKey(request, (struct AddDeleteKeyTelegram *)payload);

    } else {
#ifdef LOG_PACKET
      fprintf(stdout, "Got package of invalid type: '%c'\n", *type);
#endif
    }
  } else {
#ifdef LOG_PACKET
    fprintf(stdout, "Got package of type: '%c' seq: %d crc should be: %lu crc is: %lu\n", *type, *seq, *crc, realCRC);
#endif
  }
}

void pollComms() {

#if (USE_ETHERNET)
    static uint8_t buf[BUFFER_SIZE+1];
    uint16_t plen=enc28j60PacketReceive(BUFFER_SIZE, buf);
    buf[BUFFER_SIZE]='\0';
    if (plen){
      packetloop_icmp_tcp(buf,plen);

#ifdef LOG_PACKET
	fprintf(stdout, "Got packet len: %d\n", plen);
#endif

	if (!eth_type_is_ip_and_my_ip(buf,plen)) {
#ifdef LOG_PACKET
	  fprintf(stdout, "Not my IP\n");
#endif

	} else if (!buf[IP_PROTO_P]==IP_PROTO_UDP_V) {
#ifdef LOG_PACKET
	  fprintf(stdout, "Not UDP, but %d\n", buf[IP_PROTO_P]);
#endif

	} else if (!buf[UDP_DST_PORT_H_P]==(UDP_PORT>>8) && buf[UDP_DST_PORT_L_P]==(UDP_PORT&0xff)) {
#ifdef LOG_PACKET
	  fprintf(stdout, "Wrong UDP port: %x %x\n", buf[UDP_DST_PORT_H_P], buf[UDP_DST_PORT_L_P]);
#endif

	} else {
	
      	unsigned char *payload = buf + UDP_DATA_P;
      	unsigned int payloadlen=buf[UDP_LEN_L_P]-UDP_HEADER_LEN;

#ifdef LOG_PACKET
	fprintf(stdout, "Got packet len: %d payload len:%d\n", plen, payloadlen);
#endif

      	if (payloadlen == 16) {
      		handleTelegram(buf, payload);
      	}
      }
    }
#endif

#ifdef RS485_ID


#endif
}
