dren-dk/HAL900/(commit log)

2010-06-07 Fixed de-duplication problem in the bank-transaction load code
2010-06-16 Added hello-world code with blinky LEDs and serial port support
2010-06-24 Implemented user-state machine, unlocking on valid rfid + pin now works
2010-06-24 Added logging framework and logging of power-up
2010-06-26 Field updates, log server now understands the exit button
2010-06-26 Field hack, door controller now understands the exit button on PB7
2010-06-28 Added support for PIN code changes
2010-06-28 Moved pin stored message up on the page
2010-08-09 Started working on the new cerberus controller
    [cerberus-h2.sch]
2010-08-09 Last minute fixing
    [cerberus-h2.sch]
2010-08-13 First commit of the board
    [cerberus-h2.brd, cerberus-h2.sch]
2010-08-15 Did more minor work
    [cerberus-h2.brd, cerberus-h2.sch]
2010-08-16 More optimizing
    [cerberus-h2.brd, cerberus-h2.sch]
2010-08-16 Added schematic
2010-08-16 Added RFID reader
    [cerberus-h2.brd, cerberus-h2.sch]
2010-08-18 Implemented tweaked sniffer-nano 2.0
    [cerberus-h2.brd, cerberus-h2.sch, sniffernano2.0.brd, sniffernano2.0.sch]
2010-08-19 more polishing
    [cerberus-h2.brd, cerberus-h2.sch]
2010-08-20 Added GPIO header with the relay GPIO pins, ADC6 and ADC7 and 12V
    [cerberus-h2.brd, cerberus-h2.sch]
2010-08-26 Nu er der grapher - kræver perl-libchart sudo apt-get install libchart-perl
2010-08-26 Mere fedteri med RFID
    [cerberus-h2.brd, cerberus-h2.sch]
2010-08-27 Picked some ELFA parts
    [cerberus-h2.brd, cerberus-h2.sch]
2010-08-27 BOM with ELFA prices
    [cerberus-h2.ods]
2010-08-31 Much more tweaking
    [cerberus-h2.brd, cerberus-h2.ods, cerberus-h2.sch]
2010-09-03 Added extra field to keep track of rfid nagging
2010-09-05 New layout with Pulse trafo
    [cerberus-h2.brd, cerberus-h2.sch]
2010-09-05 Minor tweaks
    [cerberus-h2.brd]
2010-09-08 Tweaked the rj45 footprint to match the no-name ebay parts
    [cerberus-h2.brd, cerberus-h2.sch]
2010-09-11 Added Itead cam job and started using the bottom-silkscreen
    [cerberus-h2.brd]
2010-09-26 Imported fixed sniffer nano code
    [sniffernano.pde]
2010-09-27 Added manchester decoding prototype
2010-09-29 Add USB 3G modem driver
2010-09-29 Prototype rfid decoder now seems to work.
2010-10-04 Did a spot of pdf conversion
    [cerberus-h2.brd]
2010-10-20 first.. well actually second edition of the TV-begone+POV-clone
    [TV-begone_POV.sch]
2010-10-22 Fixed ENC pinout
    [cerberus-h2.brd, cerberus-h2.sch]
2010-10-26 Removed center tap on rx side
    [cerberus-h2.brd, cerberus-h2.sch]
2010-10-26 tilføjet footprints til det hele, og startet på layout.. -ish...
    [TV-begone_POV.sch]
2010-10-26 board added
    [TV-begone_POV.brd]
2010-10-27 added footprints to the lot of them.. (batt hullerne er stadig forkerte) er begyndt på board layout
    [TV-begone_POV.brd, TV-begone_POV.sch]
2010-10-28 changed C2 to ceramic cap, started routing board
    [TV-begone_POV.brd, TV-begone_POV.sch]
2010-10-28 Started moving value names out
    [cerberus-h2.brd]
2010-10-28 got it down to 5x5 cm .. and autorouted it... needs some fine tuning in the routing department, and silk screen to help the helpless... :)
    [TV-begone_POV.brd]
2010-10-29 5x5 cm routed and nice! .. pretty much done..
    [TV-begone_POV.brd]
2010-11-02 vendte resonatoren rigtigt, har flyttet POV led'erne ud på kanten, har lavet ekstra pads til IR-LED'erne
    [TV-begone_POV.brd]
2010-11-07 Started Version 2.1 work
    [cerberus-h2.brd, cerberus-h2.sch]
2010-11-07 Tweaked the heatsink for the 3.3 switcher
    [cerberus-h2.brd, cerberus-h2.sch]
2010-11-07 Bringup on new board done and RFID reader works
2010-11-08 tykkere baner, idiotsikret SW montering, navn på silkscreen - endelig version.
    [TV-begone_POV.brd]
2010-11-08 checked out to make gerber files..
    [TV-begone_POV.sch]
2010-11-09 prøvede lige at eliminere de vias under U1.. ca. halvvejs
    [TV-begone_POV.brd]
2010-11-10 Pretty much done with V 2.1
    [cerberus-h2.brd, cerberus-h2.sch]
2010-11-11 Took some advice
    [cerberus-h2.brd, cerberus-h2.sch]
2010-11-12 Reversed the FTDI connector and added bottom silkscreen
    [cerberus-h2.brd, cerberus-h2.sch]
2010-11-13 Work in progress, moving more parts to the top
    [cerberus-h2.brd, cerberus-h2.sch]
2010-11-14 fixed the frobnizzle so it doesn't screw up the oomulator :D
    [$savepcb.brd, zab-let.brd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]
2010-11-14 gerber filer up to date
2010-11-14 gerber files updated
2010-11-14 fjernet gerber fordi de er mærkelige
    [zab-let.gbl, zab-let.gbo, zab-let.gbs, zab-let.gtl, zab-let.gto, zab-let.gts]
2010-11-14 så er der gerber
    [zab-let-Back.gbl, zab-let-Front.gtl, zab-let-Mask_Back.gbs, zab-let-Mask_Front.gts, zab-let-SilkS_Back.gbo, zab-let-SilkS_Front.gto]
2010-11-14 no longer needed
    [TV-begone_POV.brd, TV-begone_POV.sch]
2010-11-14 More tweakage
    [cerberus-h2.brd, cerberus-h2.sch]
2010-11-26 Misc small changes for Hardware version 2.1
    [cerberus-h2.brd]
2010-11-26 Started version 3.0 redesign
    [cerberus-h2.brd, cerberus-h2.ods, cerberus-h2.sch, sniffernano2.0.brd, sniffernano2.0.sch]
2010-11-27 Schematic almost done for 3.0
    [cerberus-h2.brd, cerberus-h2.sch]
2010-11-27 renamed files
    [doorctrl.brd, doorctrl.sch]
2010-11-28 work in progress.
    [doorctrl.brd, doorctrl.sch]
2010-11-29 Completed H3 layout
    [doorctrl.brd, doorctrl.sch]
2010-12-01 Tried to outsmart the heap overflow error
    [aes256.c, door-ctrl.c]
2010-12-02 loddeøerne er blevet federe, footprints til Transistorer er rettet, X1 er blevet mere snug...
    [$savepcb.brd, zab-let.brd]
2010-12-06 se forum indlæg om to do listen på hackårhus forum.. pretty much done...
    [$savepcb.brd, zab-let.brd]
2010-12-06 Played around with kicad some more
    [$savepcb.brd, doorctrl-v4-ethernet.sch, doorctrl-v4-gpio.sch, doorctrl-v4-psu.sch, doorctrl-v4-relays.sch, doorctrl-v4-rfid.sch, doorctrl-v4.brd, doorctrl-v4.sch]
2010-12-06 Misc fiddling
    [doorctrl.brd, doorctrl.sch]
2010-12-08 Tried converting the rj45 connector
    [doorctrl-v4-ethernet.sch, doorctrl-v4-gpio.sch, doorctrl-v4-psu.sch, doorctrl-v4-relays.sch, doorctrl-v4-rfid.sch, doorctrl-v4.brd, doorctrl-v4.sch]
2010-12-12 Did more kicad migration, still not yet complete schematic
    [$savepcb.brd, doorctrl-v4-ethernet.sch, doorctrl-v4-gpio.sch, doorctrl-v4-psu.sch, doorctrl-v4-relays.sch, doorctrl-v4-rfid.sch, doorctrl-v4.brd, doorctrl-v4.sch]
2010-12-13 update gerber files.. sorry i'm late
    [zab-let-Back.gbl, zab-let-Front.gtl, zab-let-Mask_Back.gbs, zab-let-Mask_Front.gts, zab-let-SilkS_Back.gbo, zab-let-SilkS_Front.gto]
2010-12-13 så er der også pillet ved modstandende til LED'erne, de er nu 125 ohm
    [zab-let.brd, zab-let.sch]
2010-12-13 Added g5sb relay lib
    [$savepcb.brd, doorctrl-v4-ethernet.sch, doorctrl-v4-gpio.sch, doorctrl-v4-psu.sch, doorctrl-v4-relays.sch, doorctrl-v4-rfid.sch, doorctrl-v4.brd, doorctrl-v4.sch]
2010-12-14 Added RS485 driver datasheet
    [cerberus-h2.ods]
2010-12-15 Fixed l4960 symbol
    [doorctrl-v4-gpio.sch, doorctrl-v4-net.sch, doorctrl-v4-psu.sch, doorctrl-v4-rfid.sch, doorctrl-v4.sch]
2010-12-15 Added ENC28J60 and friends
    [doorctrl-v4-gpio.sch, doorctrl-v4-net.sch, doorctrl-v4-psu.sch, doorctrl-v4-rfid.sch, doorctrl-v4.sch]
2010-12-16 Added RS-485 transciever and connectors
    [doorctrl-v4-gpio.sch, doorctrl-v4-net.sch, doorctrl-v4-psu.sch, doorctrl-v4-rfid.sch, doorctrl-v4.sch]
2010-12-17 Added a 5V regulator for most stuff, except ENC28J60 which lives on its own 3.3v supply
    [doorctrl-v4-gpio.sch, doorctrl-v4-net.sch, doorctrl-v4-psu.sch, doorctrl-v4-rfid.sch, doorctrl-v4.sch]
2010-12-17 Added a separate sheet for rs485, so network and 3.3v psu can have a sheet of its own
    [doorctrl-rs485.sch]
2010-12-17 Misc labeling
    [doorctrl-rs485.sch, doorctrl-v4-gpio.sch, doorctrl-v4-net.sch, doorctrl-v4-psu.sch, doorctrl-v4-rfid.sch, doorctrl-v4.sch]
2010-12-18 Moved atmel.lib into libs
    [doorctrl-rs485.sch, doorctrl-v4-gpio.sch, doorctrl-v4-net.sch, doorctrl-v4-psu.sch, doorctrl-v4-rfid.sch, doorctrl-v4.sch]
2010-12-18 Fixed atmel lib to not floodfill
    [doorctrl-rs485.sch, doorctrl-v4-gpio.sch, doorctrl-v4-net.sch, doorctrl-v4-psu.sch, doorctrl-v4-rfid.sch, doorctrl-v4.sch]
2010-12-19 Added torroid coil and proper diode packages
    [$savepcb.brd, doorctrl-rs485.sch, doorctrl-v4-gpio.sch, doorctrl-v4-net.sch, doorctrl-v4-psu.sch, doorctrl-v4-rfid.sch, doorctrl-v4.brd, doorctrl-v4.sch]
2010-12-20 Started laying out the PCB for real
    [$savepcb.brd, doorctrl-rs485.sch, doorctrl-v4-gpio.sch, doorctrl-v4-net.sch, doorctrl-v4-psu.sch, doorctrl-v4-rfid.sch, doorctrl-v4.brd, doorctrl-v4.sch]
2010-12-21 Converted to 2010-12-18
    [$savepcb.brd, doorctrl-rs485.sch, doorctrl-v4-gpio.sch, doorctrl-v4-net.sch, doorctrl-v4-psu.sch, doorctrl-v4-rfid.sch, doorctrl-v4.sch]
2010-12-22 Laid out the 3.3 and the 5 V supplies
    [$savepcb.brd, doorctrl-v4.brd]
2010-12-22 Various stuff
    [$savepcb.brd, doorctrl-v4.brd]
2010-12-23 Finished the copper layers
    [$savepcb.brd, doorctrl-rs485.sch, doorctrl-v4-gpio.sch, doorctrl-v4-net.sch, doorctrl-v4-psu.sch, doorctrl-v4-rfid.sch, doorctrl-v4.brd, doorctrl-v4.sch]
2010-12-24 Did the first part of the silk
    [$savepcb.brd, doorctrl-v4.brd]
2010-12-25 Did some silk work
    [$savepcb.brd, doorctrl-rs485.sch, doorctrl-v4-gpio.sch, doorctrl-v4-net.sch, doorctrl-v4-psu.sch, doorctrl-v4-rfid.sch, doorctrl-v4.brd, doorctrl-v4.sch]
2010-12-25 Did more silk work
    [$savepcb.brd, doorctrl-v4.brd]
2010-12-27 Various tweakage
    [$savepcb.brd, doorctrl-rs485.sch, doorctrl-v4-gpio.sch, doorctrl-v4-net.sch, doorctrl-v4-psu.sch, doorctrl-v4-rfid.sch, doorctrl-v4.brd, doorctrl-v4.sch]
2010-12-28 Misc changes
    [$savepcb.brd, doorctrl-rs485.sch, doorctrl-v4-gpio.sch, doorctrl-v4-net.sch, doorctrl-v4-psu.sch, doorctrl-v4-rfid.sch, doorctrl-v4.brd, doorctrl-v4.sch]
2011-01-01 Various fixes
    [$savepcb.brd, doorctrl-rs485.sch, doorctrl-v4-gpio.sch, doorctrl-v4-net.sch, doorctrl-v4-psu.sch, doorctrl-v4-rfid.sch, doorctrl-v4.brd, doorctrl-v4.sch]
2011-01-01 Fixed annotaion for connectors and relays
    [$savepcb.brd, doorctrl-rs485.sch, doorctrl-v4-gpio.sch, doorctrl-v4-net.sch, doorctrl-v4-psu.sch, doorctrl-v4-rfid.sch, doorctrl-v4.brd, doorctrl-v4.sch]
2011-01-01 Tapeout for 4.0
    [$savepcb.brd, doorctrl-rs485.sch, doorctrl-v4-gpio.sch, doorctrl-v4-net.sch, doorctrl-v4-psu.sch, doorctrl-v4-rfid.sch, doorctrl-v4.brd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]
2011-01-01 Created copy of the files at tapeout
    [$savepcb.brd, doorctrl-rs485.sch, doorctrl-v4-ethernet.sch, doorctrl-v4-gpio.sch, doorctrl-v4-net.sch, doorctrl-v4-psu.sch, doorctrl-v4-relays.sch, doorctrl-v4-rfid.sch]
2011-01-03 Added npn/pnp level shifter for the 3v3 to 5v conversion
    [doorctrl-rs485.sch, doorctrl-v4-gpio.sch, doorctrl-v4-net.sch, doorctrl-v4-psu.sch, doorctrl-v4-rfid.sch, doorctrl-v4.sch]
2011-01-03 Laid out the level shifter and the missing CS pullup
    [$savepcb.brd, doorctrl-rs485.sch, doorctrl-v4-gpio.sch, doorctrl-v4-net.sch, doorctrl-v4-psu.sch, doorctrl-v4-rfid.sch, doorctrl-v4.brd, doorctrl-v4.sch]
2011-01-03 General cleanup, consolidated all datasheets in one dir
    [$savepcb.brd, doorctrl-rs485.sch, doorctrl-v4-ethernet.sch, doorctrl-v4-gpio.sch, doorctrl-v4-net.sch, doorctrl-v4-psu.sch, doorctrl-v4-relays.sch, doorctrl-v4-rfid.sch]
2011-01-03 Various fiddeling
    [$savepcb.brd, doorctrl-rs485.sch, doorctrl-v4-gpio.sch, doorctrl-v4-net.sch, doorctrl-v4-psu.sch, doorctrl-v4-rfid.sch, doorctrl-v4.brd, doorctrl-v4.sch]
2011-01-04 added missing libraries
    [zab-let.brd, zab-let.sch]
2011-01-04 nu skulle atmel.lib også være der.. måske..
2011-01-07 Fixed initial fuse burning
2011-01-15 Added kicad2elfa part finder
2011-01-16 changed pin 13 on U1 to match the rest
    [zab-let.brd]
2011-01-17 Various cleanups
    [doorctrl-rs485.sch, doorctrl-v4-gpio.sch, doorctrl-v4-net.sch, doorctrl-v4-psu.sch, doorctrl-v4-rfid.sch, doorctrl-v4.sch]
2011-01-17 Misc price cleanup
    [doorctrl-rs485.sch, doorctrl-v4-gpio.sch, doorctrl-v4-net.sch, doorctrl-v4-psu.sch, doorctrl-v4-rfid.sch, doorctrl-v4.sch]
2011-01-23 Started porting software, now working: Power, Ethernet, Serial, Relays, Rfid, Charlie plexing. Still TODO: wiegand,rs485, application
2011-01-23 Fixed a couple of bugs: No more level shifter and rfid carrier wave output is connected correctly
    [doorctrl-rs485.sch, doorctrl-v4-gpio.sch, doorctrl-v4-net.sch, doorctrl-v4-psu.sch, doorctrl-v4-rfid.sch, doorctrl-v4.sch]
2011-01-24 Did more porting, wiegand cleaned up, but doesn't quite work yet.
    [door-ctrl.c, enc28j60.c, enc28j60.h, ip_arp_udp_tcp.c, ip_arp_udp_tcp.h, rfid.c, wiegand.c, wiegand.h]
2011-01-27 fixed the weird LED pad.. now they're all the same size..
    [zab-let.brd]
2011-02-04 Fixed compilation in eclipse project, chars need to be fucking signed, you rotten bastard
    [door-ctrl.c, rfid.c, uart.c, wiegand.c]
2011-02-04 Fixed RFID carrier wave port
    [doorctrl-rs485.sch, doorctrl-v4-gpio.sch, doorctrl-v4-net.sch, doorctrl-v4-psu.sch, doorctrl-v4-rfid.sch, doorctrl-v4.sch]
2011-02-08 Fixed rfid sync logic
    [24c64.c]
2011-02-10 Added driver for the external 24LC64 EEPROM
2011-02-13 Moved the relay routines to a separate file for better self-documentation
2011-02-14 Made Wiegand work again and cut down on the configurability of the wiegand interface
2011-02-20 Finally fixed networking: the MAC address can't have bit 0 set
    [door-ctrl.c, ip_arp_udp_tcp.c]
2011-02-22 Switched From on HAL mails to the treasurer
2011-03-10 Re-routed wire to allow safer bridging of protection resistors
    [$savepcb.brd, doorctrl-rs485.sch, doorctrl-v4-gpio.sch, doorctrl-v4-net.sch, doorctrl-v4-psu.sch, doorctrl-v4-rfid.sch, doorctrl-v4.brd, doorctrl-v4.sch]
2011-03-10 Listed a few more kicad bugs
2011-03-21 Did various cleanups, added mounting holes to the schematic, so they don't disappear and grounded them, removed the redundant levelshifter
    [$savepcb.brd, doorctrl-rs485.sch, doorctrl-v4-gpio.sch, doorctrl-v4-net.sch, doorctrl-v4-psu.sch, doorctrl-v4-rfid.sch, doorctrl-v4.brd, doorctrl-v4.sch]
2011-05-03 Switched From on the automagic emails
2012-09-21 Fixed test code to actually work
    [rfid-manchester-decoder-unbuffered.c]
2013-11-18 Fixed to actually compile now
    [ip_arp_udp_tcp.c, ip_arp_udp_tcp.h, wiegand.c]
2013-11-20 Fixed to the over all state machine and debugged a few wonky bits here and there, so it all seems to work correctly now
    [comms.c, defines.h, door-ctrl.c, wiegand.c]
2013-11-20 Allow the user to cancel pin entry and lock the door by hitting esc
2013-11-25 Fixed state machine so it resets correctly
    [door-ctrl.c, wiegand.c]
2016-02-03 Switched off mx validation
